bismarx-v1/KiCAD_libs/README.md

# KiCAD_libs
Library folders for KiCAD, symbols, footprints and 3D models, also contains templates, themes and drawing sheets.
