bismarx-v1/KiCAD_libs/3d_models/gps-compass_3d/START_MODULE.step

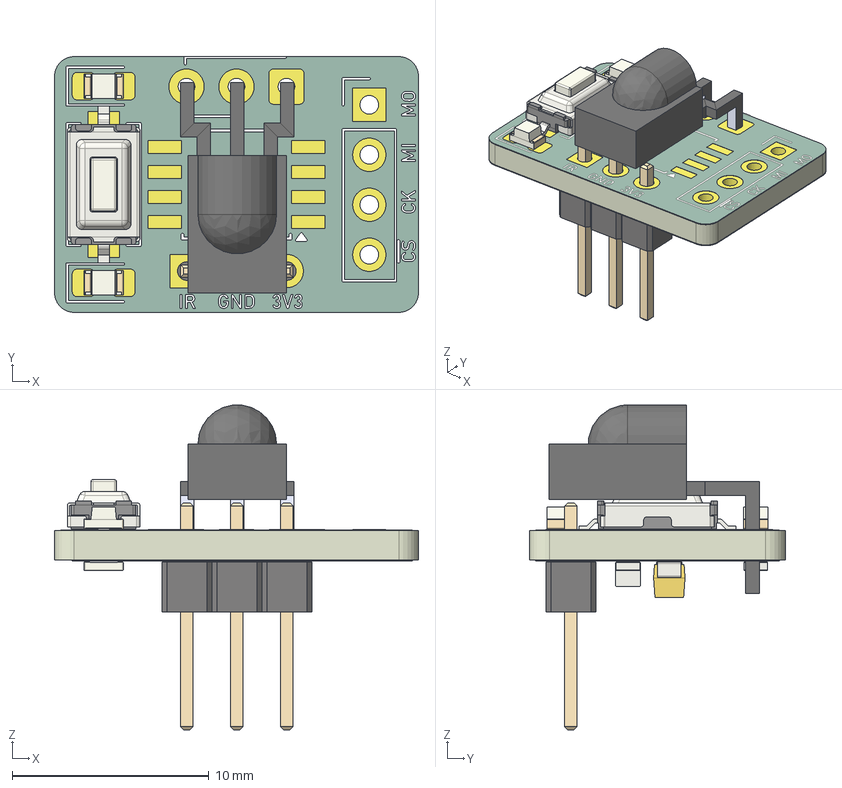
[picture p1: CAD file, 2025-10-14]
3d_models/gps-compass_3d/START_MODULE.step
18.5 x 13.0 x 16.5 mm
SW_Tactile_SPST_NO_Straight_CK_PTS636Sx25SMTRLFS
LED_0805_2012Metric x 2
R_0805_2012Metric x 3
CP_EIA-3216-18_Kemet-A
C_0805_2012Metric
PinHeader_1x03_P2.54mm_Vertical
START_MODULE_copper
START_MODULE_silkscreen
START_MODULE_soldermask
START_MODULE_PCB
