bismarx-v1/KiCAD_libs/3d_models/gps-compass_3d/DRV8834RGER.step

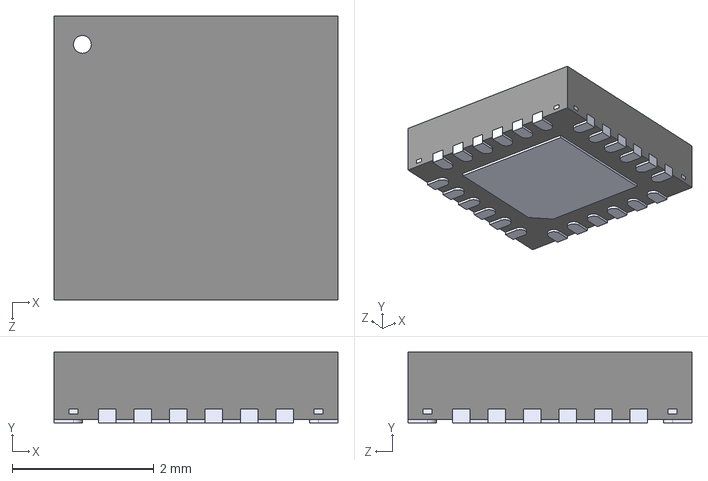
[picture p2: CAD file, 2025-10-14]
3d_models/gps-compass_3d/DRV8834RGER.step
4.00 x 1.00 x 4.00 mm
