bismarx-v1/KiCAD_libs/3d_models/gps-compass_3d/QFN-16 (3x3).stp

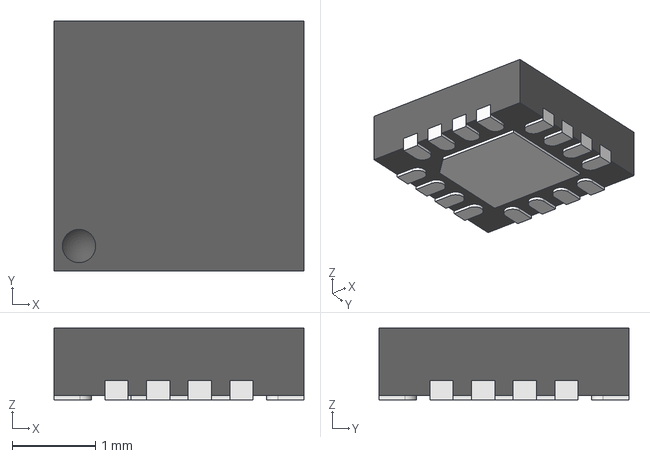
[picture p3: CAD file, 2025-10-14]
3d_models/gps-compass_3d/QFN-16 (3x3).stp
3.00 x 3.00 x 0.86 mm
QFN-16 (3x3) Part1
QFN-16 (3x3) Part2 x 16
