bismarx-v1/KiCAD_libs/3d_models/gps-compass_3d/IC-MB3 TSSOP24--3DModel-STEP-510211.STEP

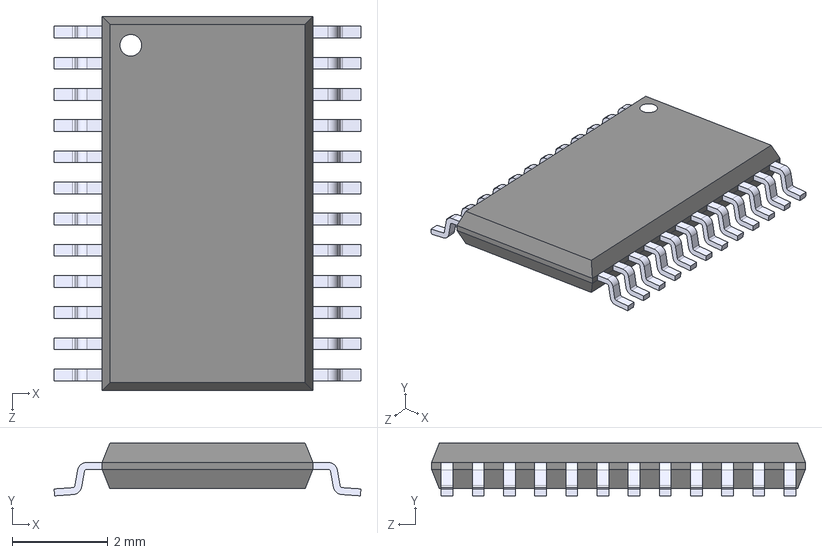
[picture p4: CAD file, 2025-10-14]
3d_models/gps-compass_3d/IC-MB3 TSSOP24--3DModel-STEP-510211.STEP
6.40 x 1.10 x 7.80 mm
