bismarx-v1/KiCAD_libs/3d_models/gps-compass_3d/LIPO_BATT.step

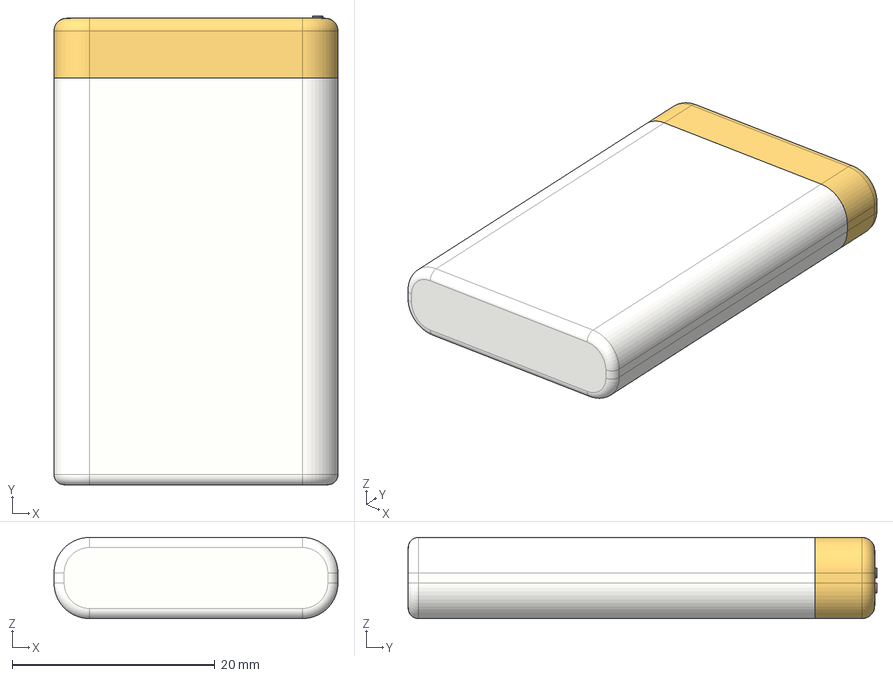
[picture p5: CAD file, 2025-10-14]
3d_models/gps-compass_3d/LIPO_BATT.step
28.0 x 46.2 x 8.00 mm
