bismarx-v1/KiCAD_libs/3d_models/gps-compass_3d/ABM8G-16.000MHZ-18-D2Y-T.stp

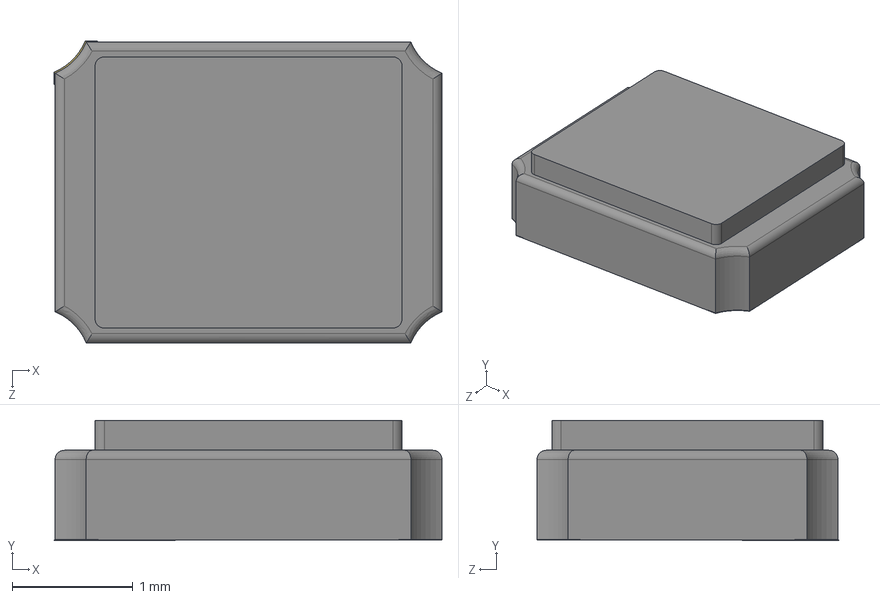
[picture p6: CAD file, 2025-10-14]
3d_models/gps-compass_3d/ABM8G-16.000MHZ-18-D2Y-T.stp
3.21 x 0.996 x 2.50 mm
ABM8G_1
ABM8G_2
ABM8G
ABM8G_4
ABM8G_3
