bismarx-v1/KiCAD_libs/3d_models/gps-compass_3d/SMA-angled.STEP

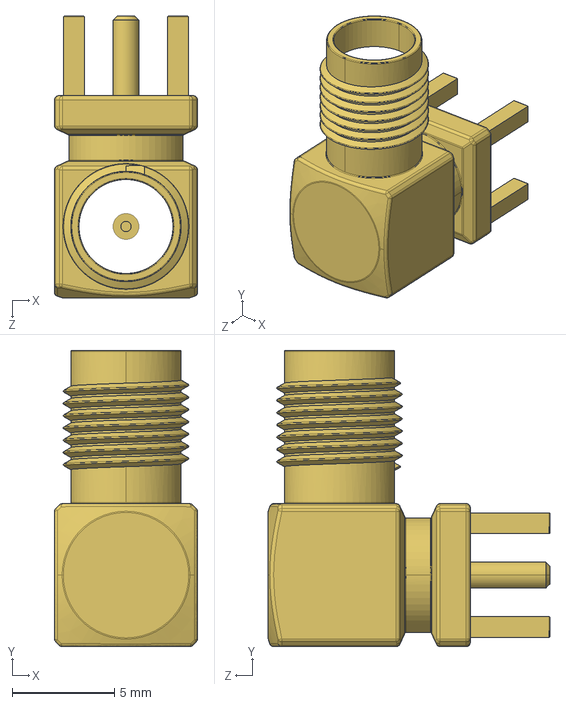
[picture p7: CAD file, 2025-10-14]
3d_models/gps-compass_3d/SMA-angled.STEP
7.00 x 14.5 x 13.8 mm
