bismarx-v1/KiCAD_libs/3d_models/gps-compass_3d/SMD_DIP_SWITCH_5P.step

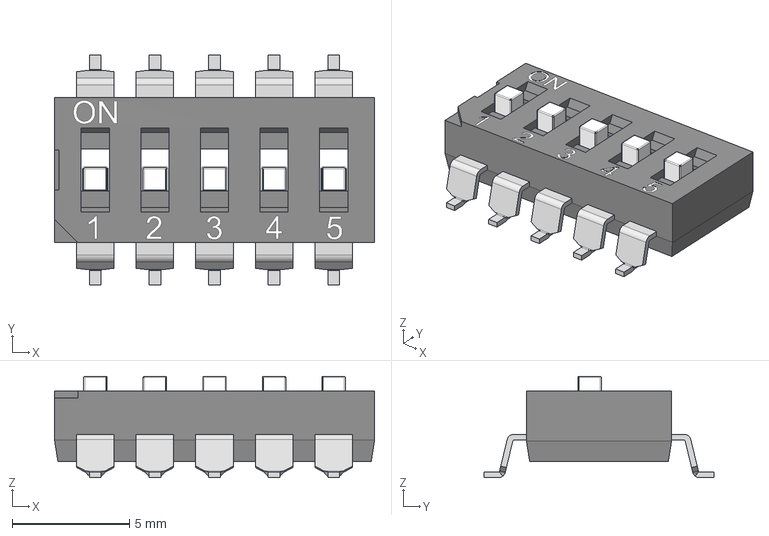
[picture p8: CAD file, 2025-10-14]
3d_models/gps-compass_3d/SMD_DIP_SWITCH_5P.step
13.6 x 9.80 x 4.32 mm
