bismarx-v1/KiCAD_libs/3d_models/gps-compass_3d/AST0827MW-03BTRQ_MAL.step

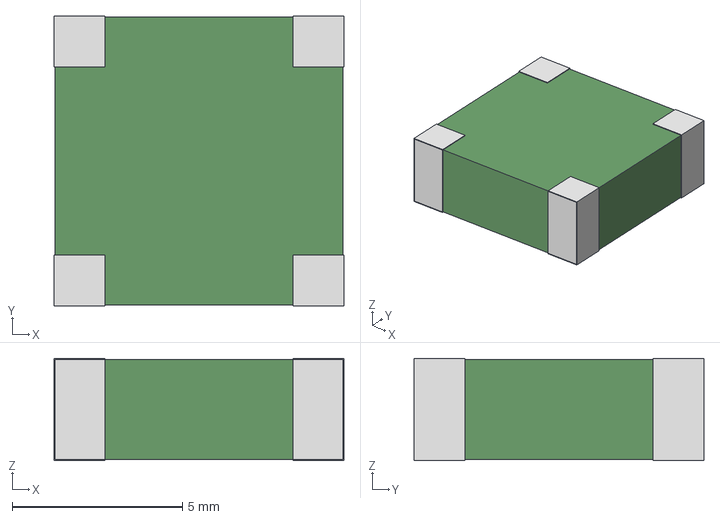
[picture p9: CAD file, 2025-10-14]
3d_models/gps-compass_3d/AST0827MW-03BTRQ_MAL.step
8.51 x 8.51 x 3.00 mm
