bismarx-v1/KiCAD_libs/3d_models/gps-compass_3d/XT30PW-M.step

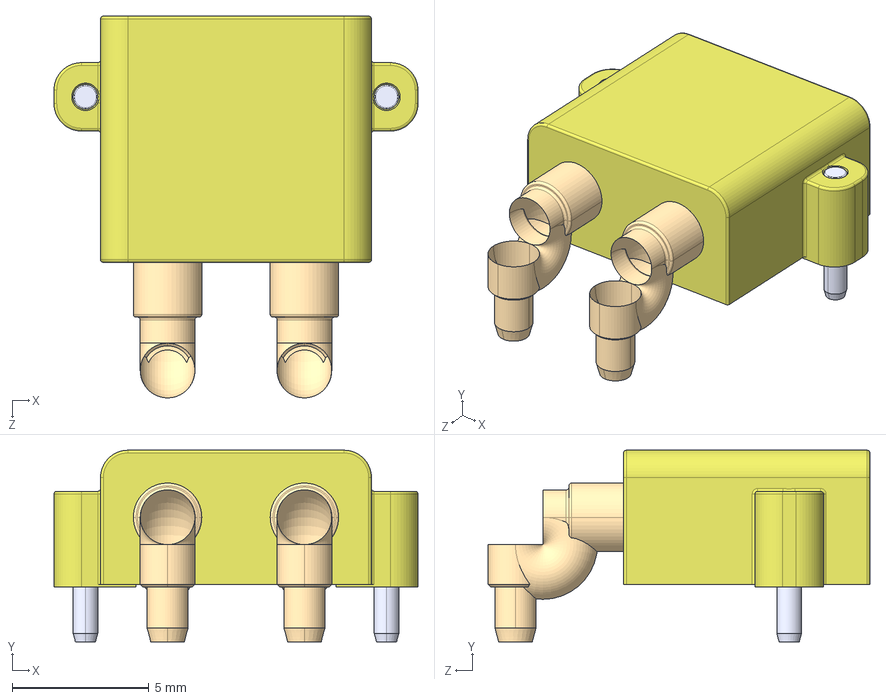
[picture p10: CAD file, 2025-10-14]
3d_models/gps-compass_3d/XT30PW-M.step
13.3 x 7.00 x 14.0 mm
