bismarx-v1/KiCAD_libs/3d_models/gps-compass_3d/CPT-2016-75-SMT-TR.step

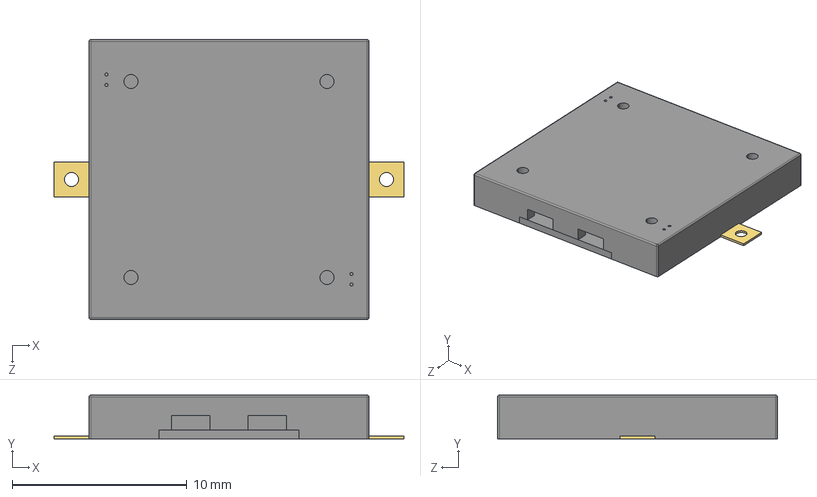
[picture p11: CAD file, 2025-10-14]
3d_models/gps-compass_3d/CPT-2016-75-SMT-TR.step
20.0 x 2.50 x 16.0 mm
