bismarx-v1/KiCAD_libs/3d_models/gps-compass_3d/SPDT slide switch SS12D00.step

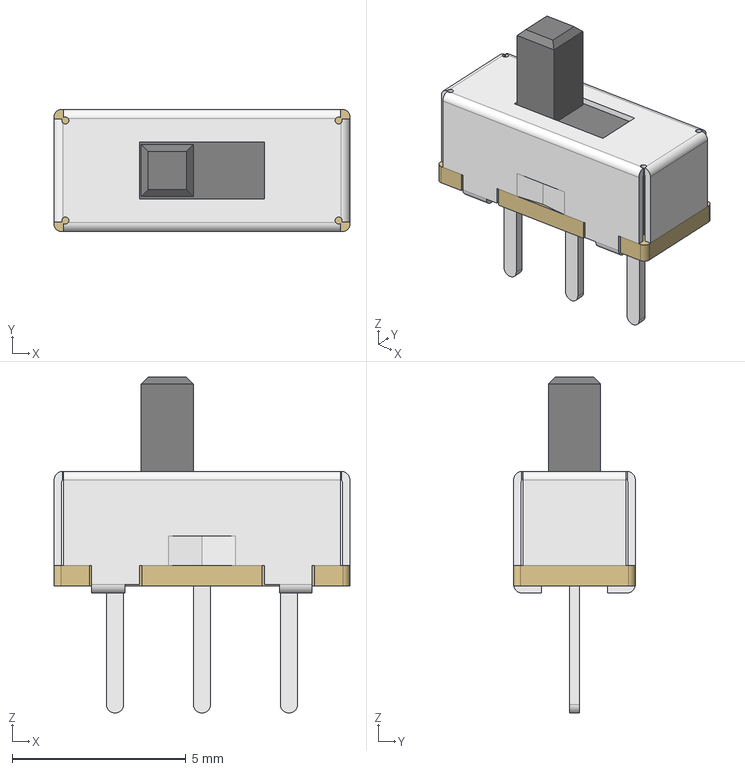
[picture p12: CAD file, 2025-10-14]
3d_models/gps-compass_3d/SPDT slide switch SS12D00.step
8.50 x 3.50 x 9.66 mm
