bismarx-v1/KiCAD_libs/3d_models/gps-compass_3d/CMT-8504-100 BUZZER.step

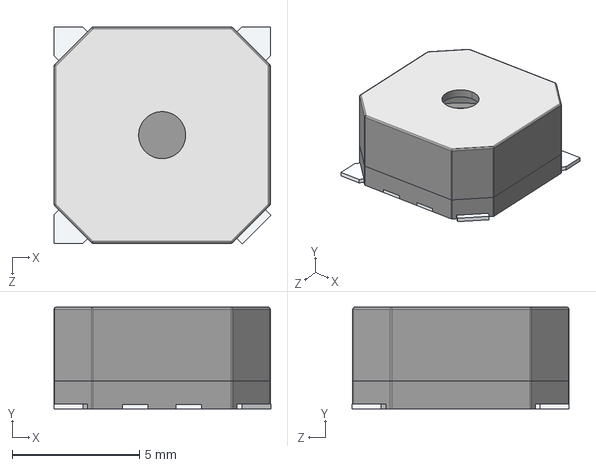
[picture p13: CAD file, 2025-10-14]
3d_models/gps-compass_3d/CMT-8504-100 BUZZER.step
8.53 x 4.00 x 8.53 mm
