bismarx-v1/KiCAD_libs/3d_models/gps-compass_3d/TYPE-C-31-M-12.step

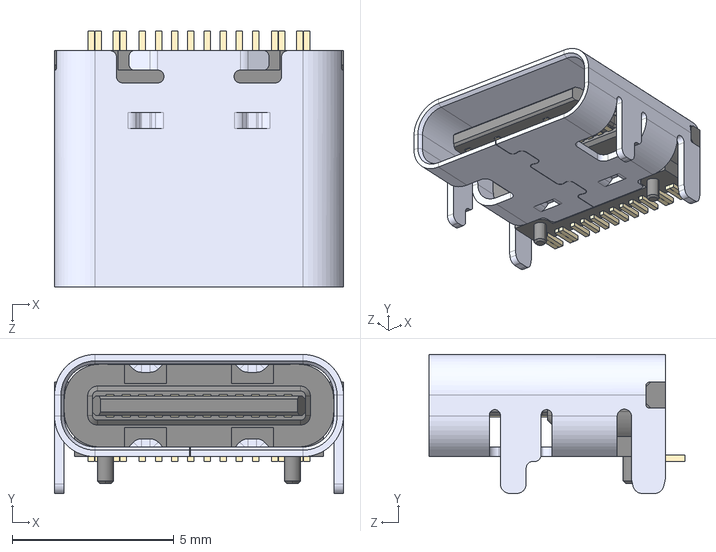
[picture p14: CAD file, 2025-10-14]
3d_models/gps-compass_3d/TYPE-C-31-M-12.step
8.94 x 4.30 x 7.90 mm
