bismarx-v1/KiCAD_libs/3d_models/gps-compass_3d/YC158TJR-0710KL.stp

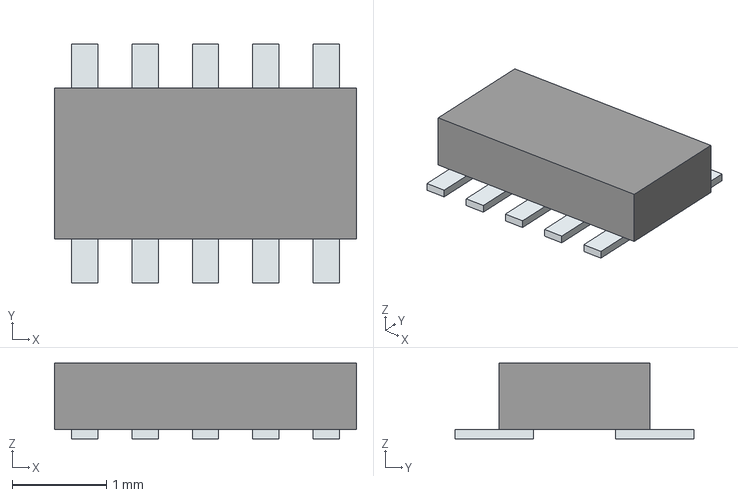
[picture p15: CAD file, 2025-10-14]
3d_models/gps-compass_3d/YC158TJR-0710KL.stp
3.20 x 2.53 x 0.8 mm
Pins
