bismarx-v1/KiCAD_libs/3d_models/gps-compass_3d/SPDT_Switch_lever.step

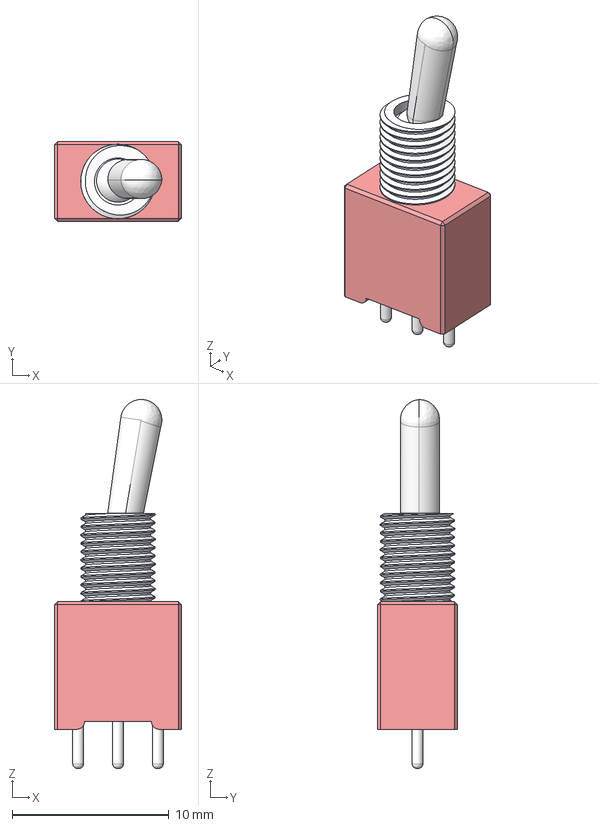
[picture p16: CAD file, 2025-10-14]
3d_models/gps-compass_3d/SPDT_Switch_lever.step
8.10 x 5.10 x 23.5 mm
