bismarx-v1/KiCAD_libs/3d_models/gps-compass_3d/DRV8874.stp

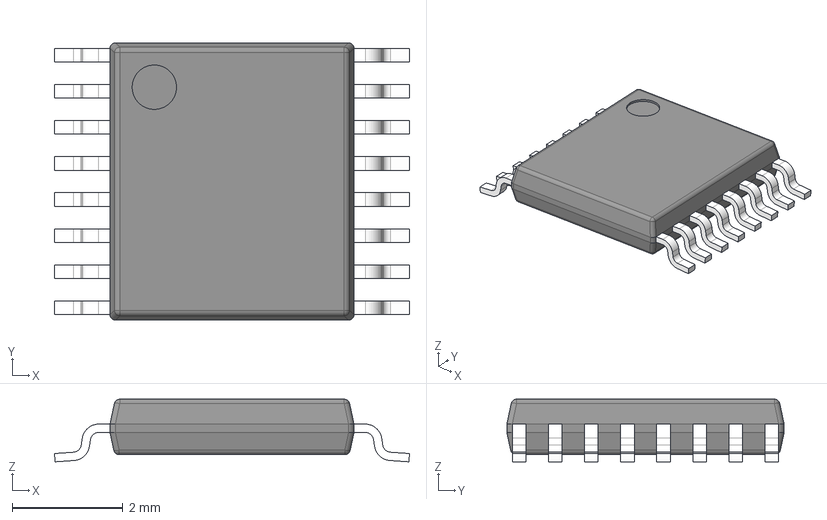
[picture p17: CAD file, 2025-10-14]
3d_models/gps-compass_3d/DRV8874.stp
6.40 x 5.00 x 1.13 mm
BODY-TSSOP
LEAD-TSSOP x 16
PIN1
DAP
