bismarx-v1/KiCAD_libs/3d_models/gps-compass_3d/TSOP382.stp

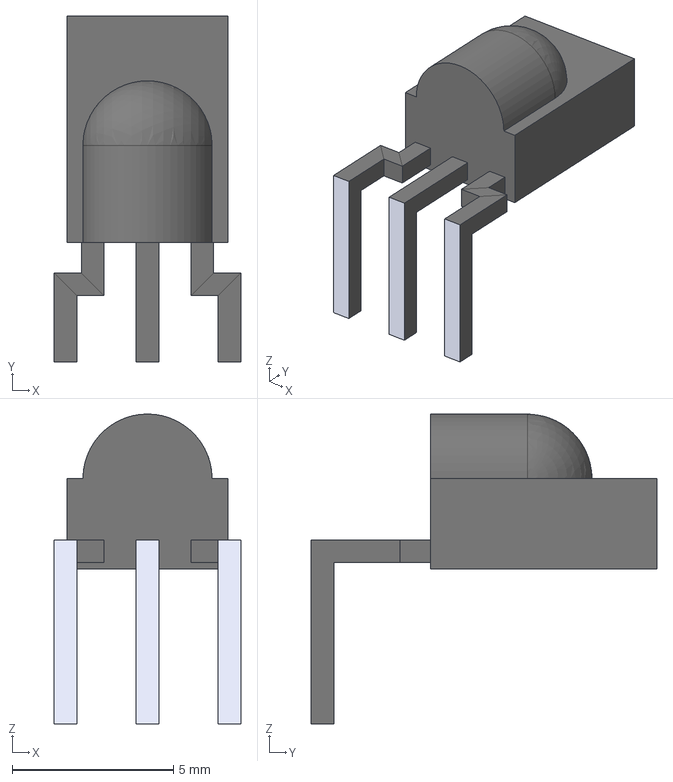
[picture p19: CAD file, 2025-10-14]
3d_models/gps-compass_3d/TSOP382.stp
5.78 x 10.7 x 9.60 mm
