bismarx-v1/KiCAD_libs/3d_models/gps-compass_3d/YC248-JR-0710KL.stp

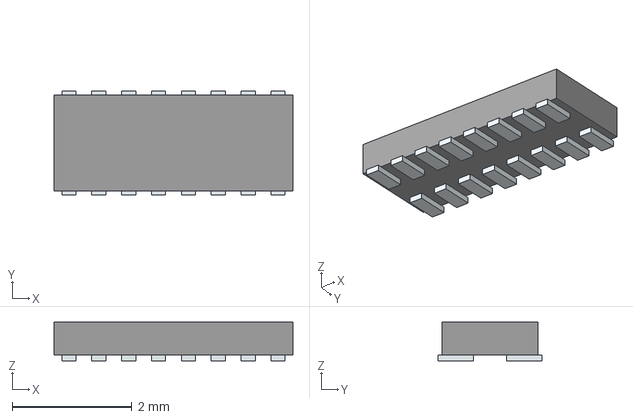
[picture p20: CAD file, 2025-10-14]
3d_models/gps-compass_3d/YC248-JR-0710KL.stp
4.00 x 1.74 x 0.65 mm
Pins
