bismarx-v1/KiCAD_libs/3d_models/gps-compass_3d/teseo-liv3f.stp

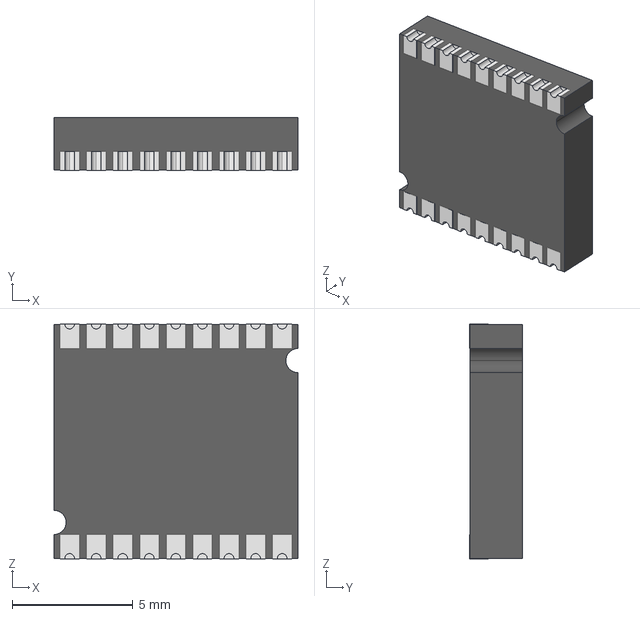
[picture p21: CAD file, 2025-10-14]
3d_models/gps-compass_3d/teseo-liv3f.stp
10.1 x 2.19 x 9.71 mm
