bismarx-v1/KiCAD_libs/3d_models/gps-compass_3d/JST-XH6-SMD.step

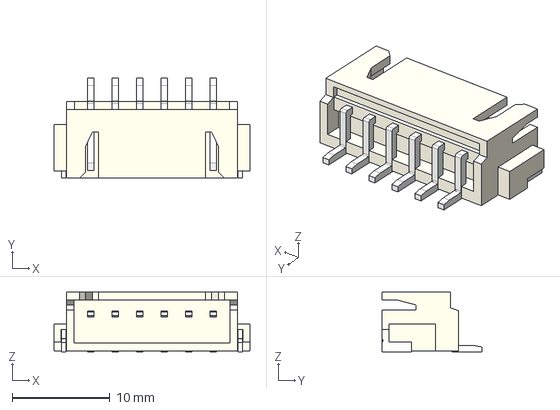
[picture p22: CAD file, 2025-10-14]
3d_models/gps-compass_3d/JST-XH6-SMD.step
20.0 x 10.2 x 6.10 mm
