bismarx-v1/KiCAD_libs/3d_models/gps-compass_3d/SOP-24_6.0x13.0mm_P1.0mm.step

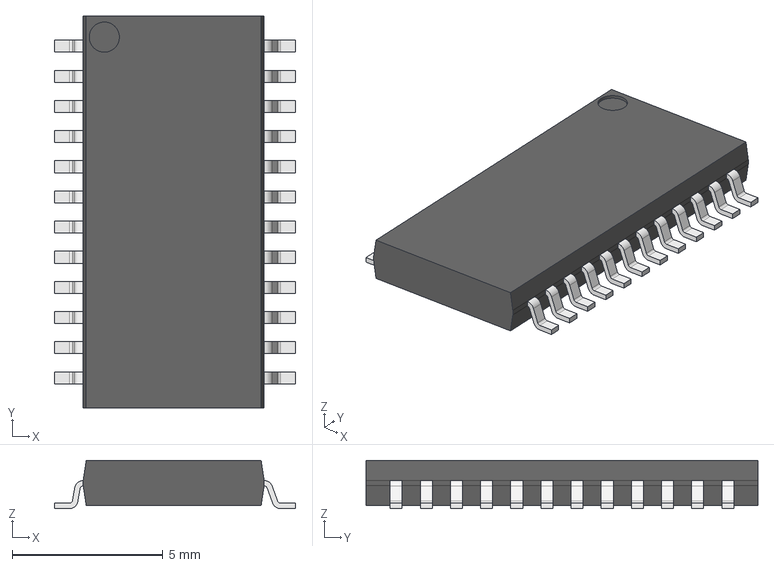
[picture p23: CAD file, 2025-10-14]
3d_models/gps-compass_3d/SOP-24_6.0x13.0mm_P1.0mm.step
8.00 x 13.0 x 1.60 mm
