bismarx-v1/KiCAD_libs/3d_models/gps-compass_3d/ANT2525B00DT1516S.stp

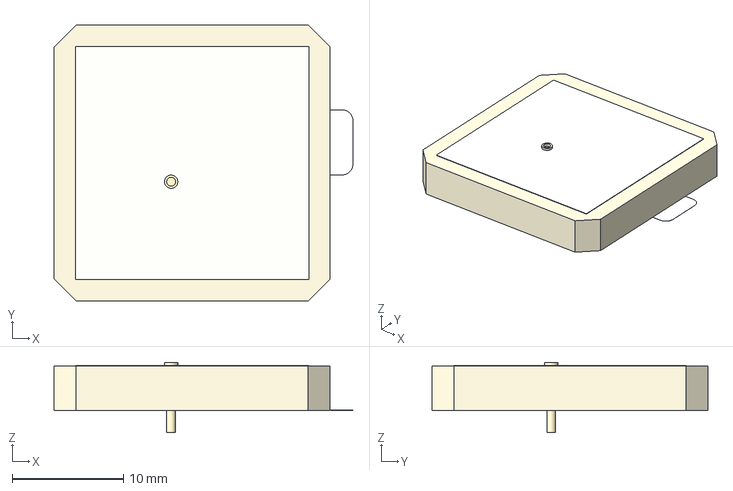
[picture p24: CAD file, 2025-10-14]
3d_models/gps-compass_3d/ANT2525B00DT1516S.stp
26.9 x 24.9 x 6.30 mm
