bismarx-v1/KiCAD_libs/3d_models/gps-compass_3d/KTS1605EUB-1-TR.stp

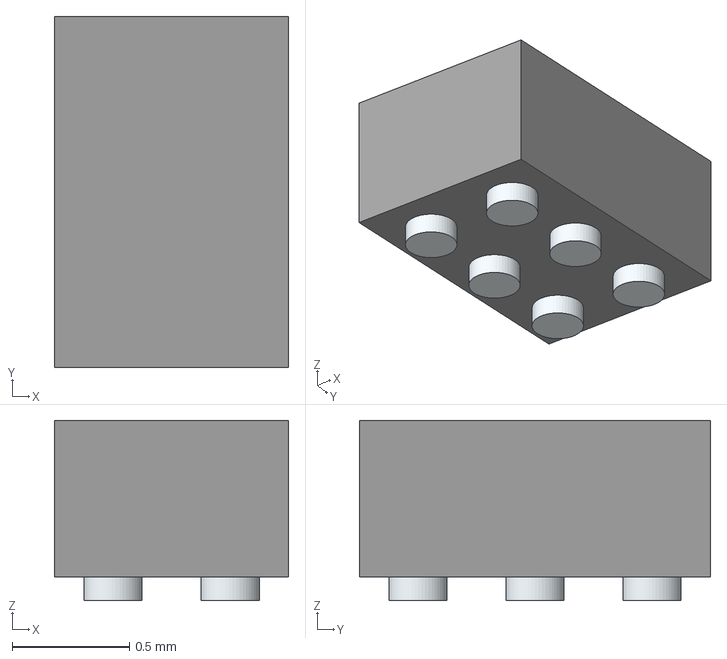
[picture p25: CAD file, 2025-10-14]
3d_models/gps-compass_3d/KTS1605EUB-1-TR.stp
1.00 x 1.50 x 0.77 mm
Pins
