bismarx-v1/KiCAD_libs/3d_models/gps-compass_3d/LiPo Battery v5.step

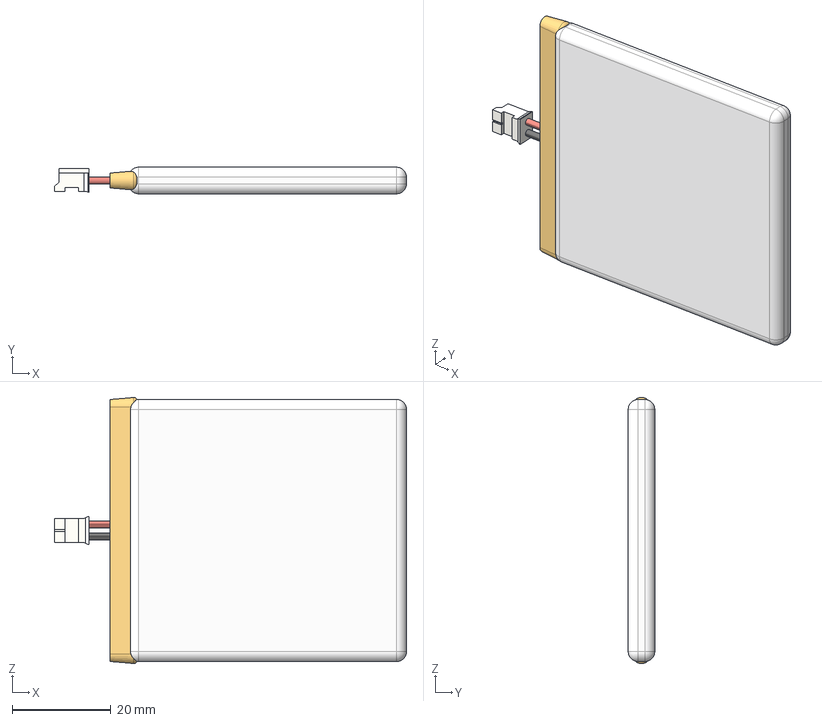
[picture p27: CAD file, 2025-10-14]
3d_models/gps-compass_3d/LiPo Battery v5.step
71.2 x 5.38 x 53.8 mm
