bismarx-v1/KiCAD_libs/3d_models/gps-compass_3d/SPDT_Switch_piano_noHoles.stp

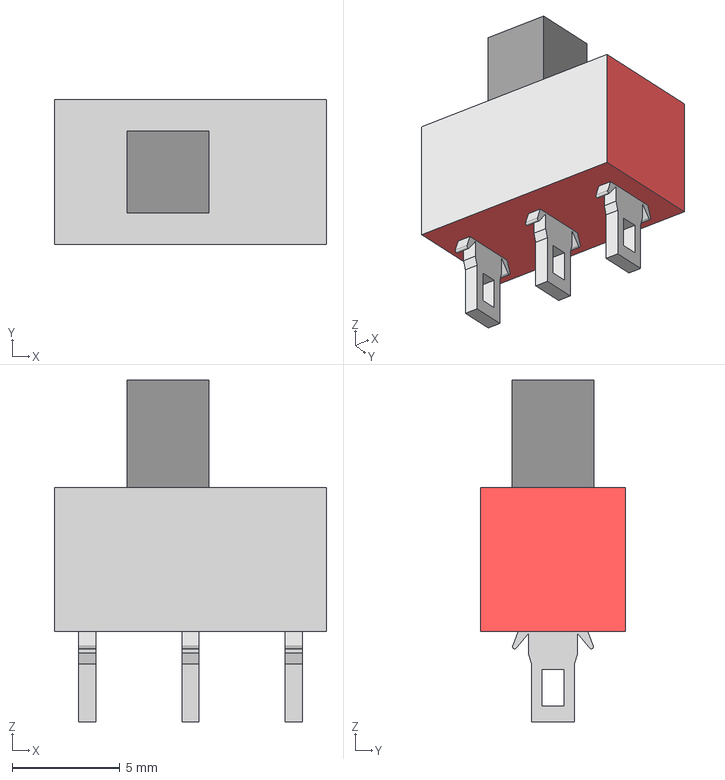
[picture p28: CAD file, 2025-10-14]
3d_models/gps-compass_3d/SPDT_Switch_piano_noHoles.stp
12.7 x 6.75 x 15.9 mm
