bismarx-v1/KiCAD_libs/3d_models/gps-compass_3d/XT30M.stp

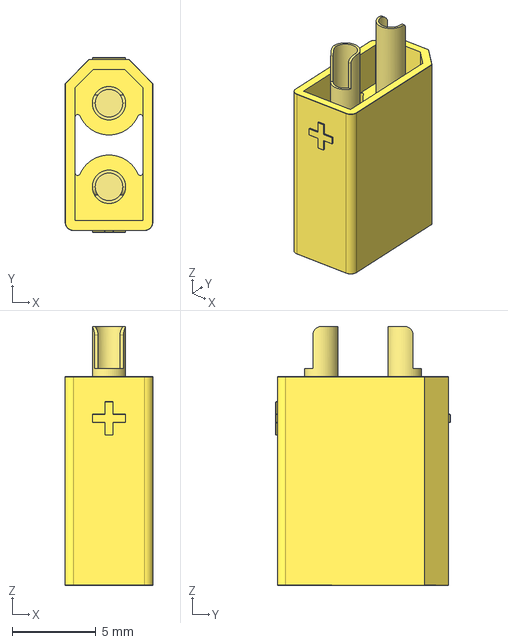
[picture p29: CAD file, 2025-10-14]
3d_models/gps-compass_3d/XT30M.stp
5.25 x 10.4 x 15.5 mm
