bismarx-v1/KiCAD_libs/3d_models/gps-compass_3d/FFC2B28-12-G.step

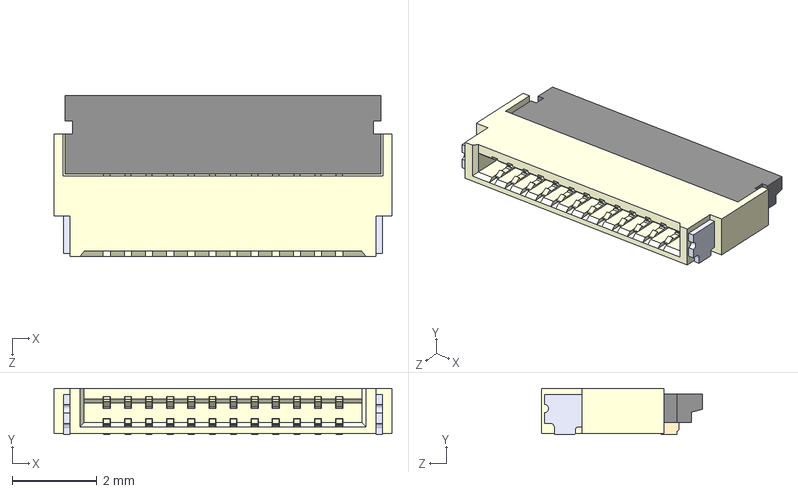
[picture p30: CAD file, 2025-10-14]
3d_models/gps-compass_3d/FFC2B28-12-G.step
8.00 x 1.10 x 3.80 mm
