bismarx-v1/KiCAD_libs/3d_models/gps-compass_3d/ANTENNA_GNSS.STEP

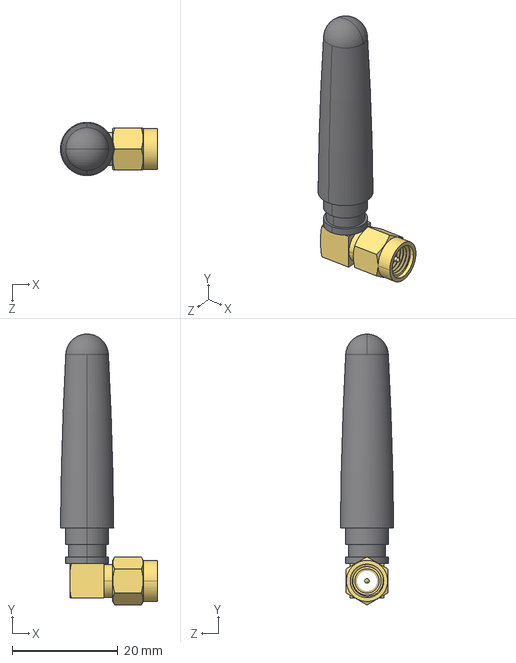
[picture p31: CAD file, 2025-10-14]
3d_models/gps-compass_3d/ANTENNA_GNSS.STEP
18.4 x 51.3 x 10.1 mm
