bismarx-v1/KiCAD_libs/(list of files, cad)

Other CAD files:
3d_models/gps-compass_3d/B39162B4327P810--3DModel-STEP-510211.STEP
3d_models/gps-compass_3d/B39162B4327P810.step
